baragona/ThinComputerElectrical/README.md

# ThinComputerElectrical
Thin Computer Electrical design
