baragona/ThinComputerElectrical/powerboard.pdf

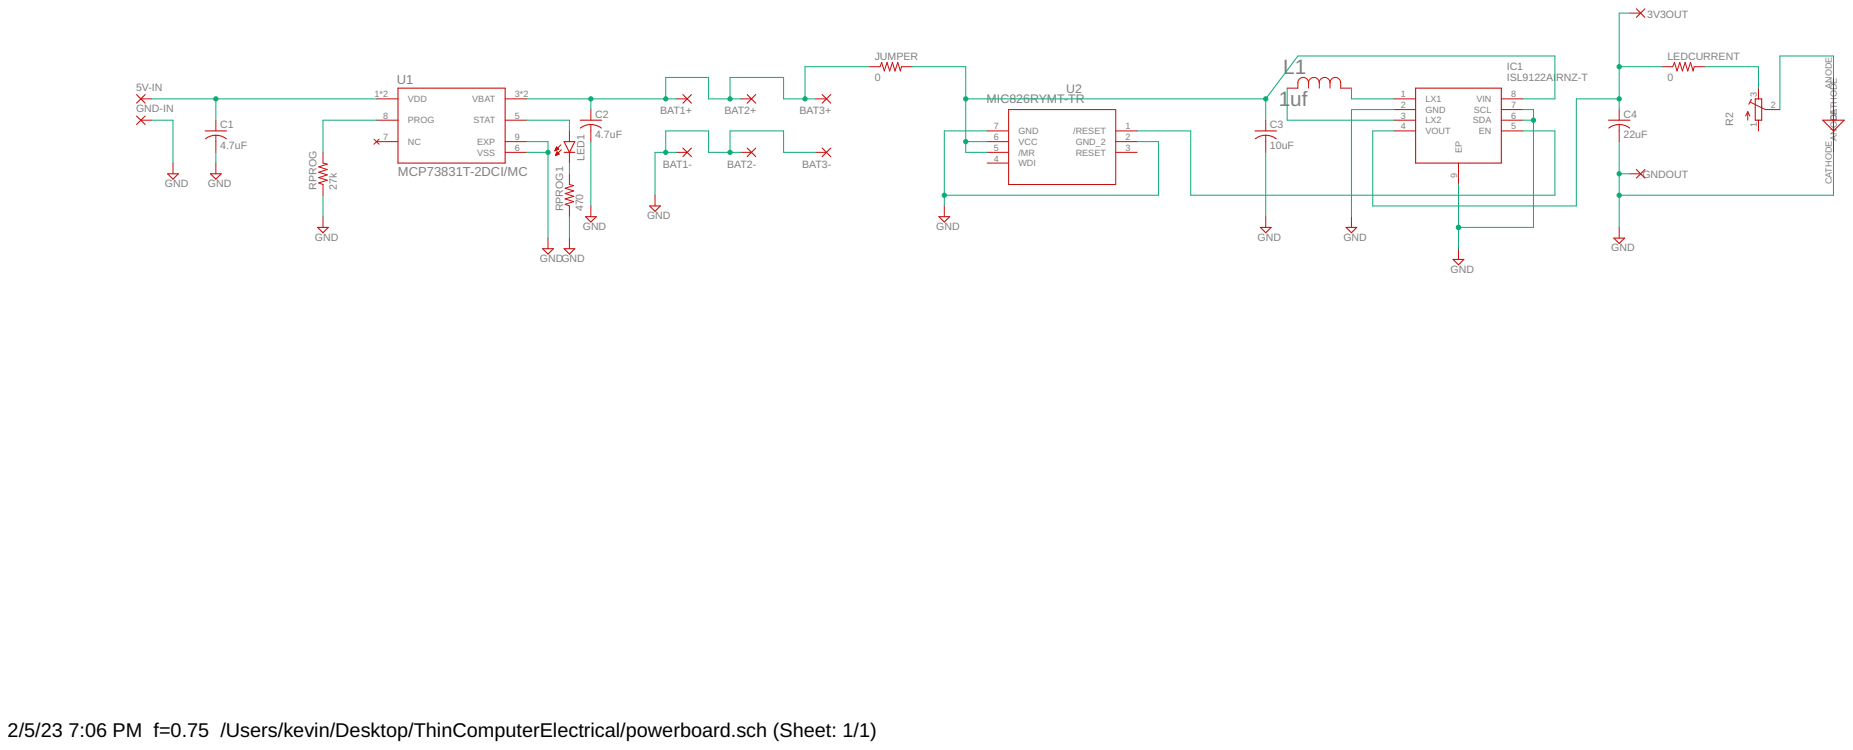
[picture p1: page 1]

2/5/23 7:06 PM f=0.75 /Users/kevin/Desktop/ThinComputerElectrical/powerboard.sch (Sheet: 1/1)
