baragona/ThinComputerElectrical/powerboard.brd

## EAGLE design powerboard.brd (2023-02-19)

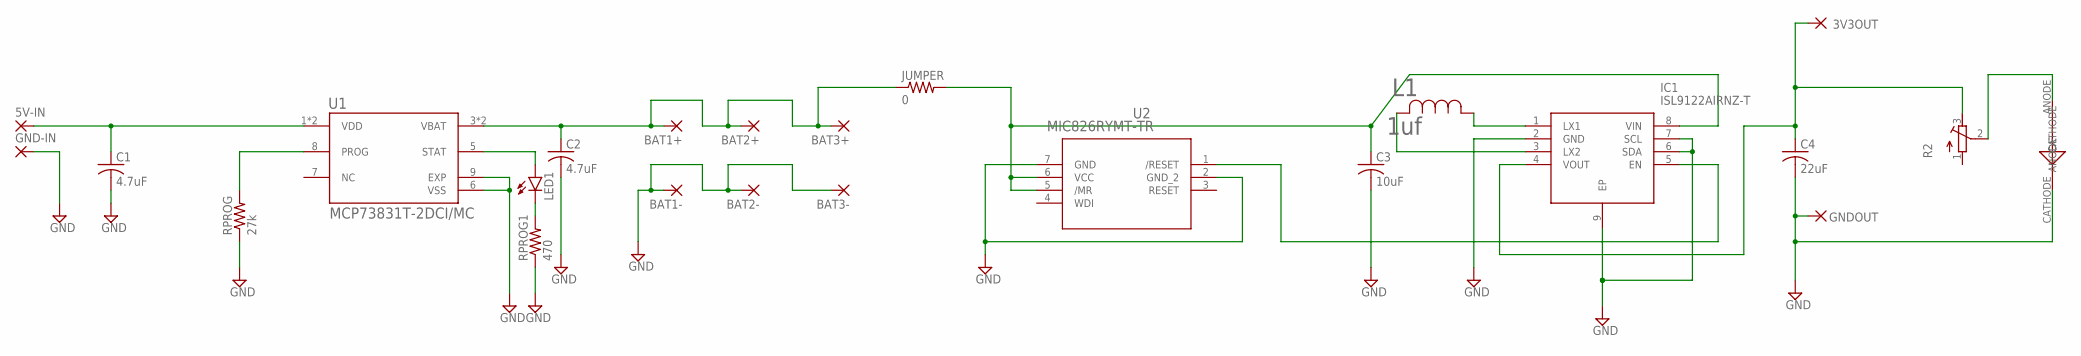
[picture p2: schematic powerboard.sch]

Parts:
3V3OUT, 5V-IN: 2,54/0,9
BAT1+, BAT1-, BAT2+, BAT2-, BAT3+, BAT3-: 2,54/0,9
C1, C2: 4.7uF; C0603K
C3: 10uF; C0603K
C4: 22uF; C0603K
GND-IN: 2,54/0,9
GNDOUT: 2,54/0,9
IC1: ISL9122AIRNZ-T; SON50P300X200X100-9N
JUMPER: 0; R0805
L1: 1uf; IND_IHHP-0806ZH-01_VIS
LED1: LEDCHIPLED_0603; CHIPLED_0603
R2: R-TRIMM3165W; RTRIM3165W
RPROG: 27k; R0402
RPROG1: 470; R0402
U1: MCP73831T-2DCI/MC; SON50P200X300X100-9N
U2: MIC826RYMT-TR; UDFN6_HKA_MCH
U$1: CHIPLED; CHIPLED2828

Connections:
3.3REGULATED: 3V3OUT.1, C4.1, IC1.4 (VOUT), R2.3 (E)
5VIN: 5V-IN.1, C1.1, U1.1 (VDD), U1.2 (VDD)
BAT_IN: C3.1, IC1.8 (VIN), JUMPER.2, U2.5 (/MR), U2.6 (VCC)
GND: BAT1-.1, BAT2-.1, BAT3-.1, C1.2, C2.2, C3.2, C4.2, GND-IN.1, GNDOUT.1, IC1.2 (GND), IC1.6 (SDA), IC1.7 (SCL), IC1.9 (EP), RPROG.1, RPROG1.1, U1.6 (VSS), U1.9 (EXP), U2.2 (GND_2), U2.7 (GND), U$1.CATHODE
INDUCTOR1: IC1.3 (LX2), L1.2
INDUCTOR2: IC1.1 (LX1), L1.1
JUMPER: BAT1+.1, BAT2+.1, BAT3+.1, C2.1, JUMPER.1, U1.3 (VBAT), U1.4 (VBAT)
LED+: R2.2 (S), U$1.ANODE
unnamed: RPROG.2, U1.8 (PROG)
unnamed: LED1.A, U1.5 (STAT)
unnamed: LED1.C, RPROG1.2
unnamed: IC1.5 (EN), U2.1 (/RESET)

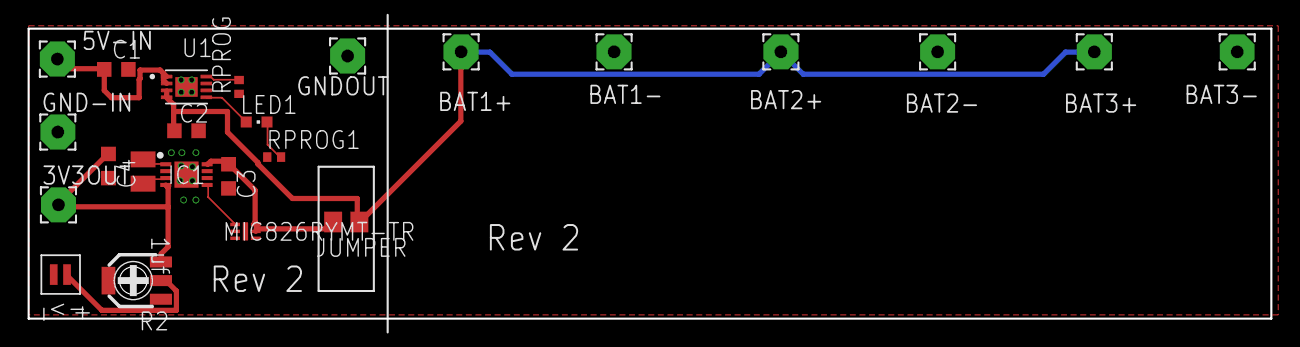
[picture p3: board powerboard.brd from above]

Board: 2 copper layers, 90.0 x 21.0 mm, 24 parts (0 on the bottom side), 12 nets.
