baragona/ThinComputerElectrical/usbctest.brd

## EAGLE design usbctest.brd (2023-02-19)

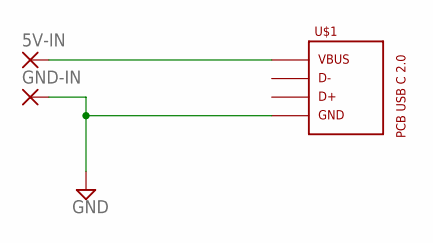
[picture p4: schematic usbctest.sch]

Parts:
5V-IN: 2,54/0,9
GND-IN: 2,54/0,9
U$1: PCB_USB_C_2.0W_2; USB_TYPE_C_W_2.0_2

Connections:
5VIN: 5V-IN.1, U$1.VBUS
GND: GND-IN.1, U$1.GND

Board: 2 copper layers, 3 parts (0 on the bottom side), 2 nets, no tracks yet.
