baragona/ThinComputerElectrical/(commit log)

2023-01-26 place some parts
    [powerboard.brd, powerboard.sch]
2023-01-27 add jlc rules, edit mic826 footprint
    [powerboard.brd, powerboard.sch]
2023-01-28 add gerber export
    [copper_bottom.gbr, copper_top.gbr, gerber_job.gbrjob, profile.gbr, silkscreen_bottom.gbr, silkscreen_top.gbr, soldermask_bottom.gbr, soldermask_top.gbr]
2023-02-06 add schematic pdf
2023-02-06 add digikey bom
    [digikey BOM.csv]
2023-02-19 update powerboard with fixes
    [powerboard.brd, powerboard.sch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]
