baragona/ThinComputerElectrical/(notices)

Notices in the files:
parts and their libraries:
mic826rymt-tr: COPYRIGHT: Copyright (C) 2023 Ultra Librarian. All rights reserved.
